rajatchaple/pcb_practice1/images/20220228_100533.jpg

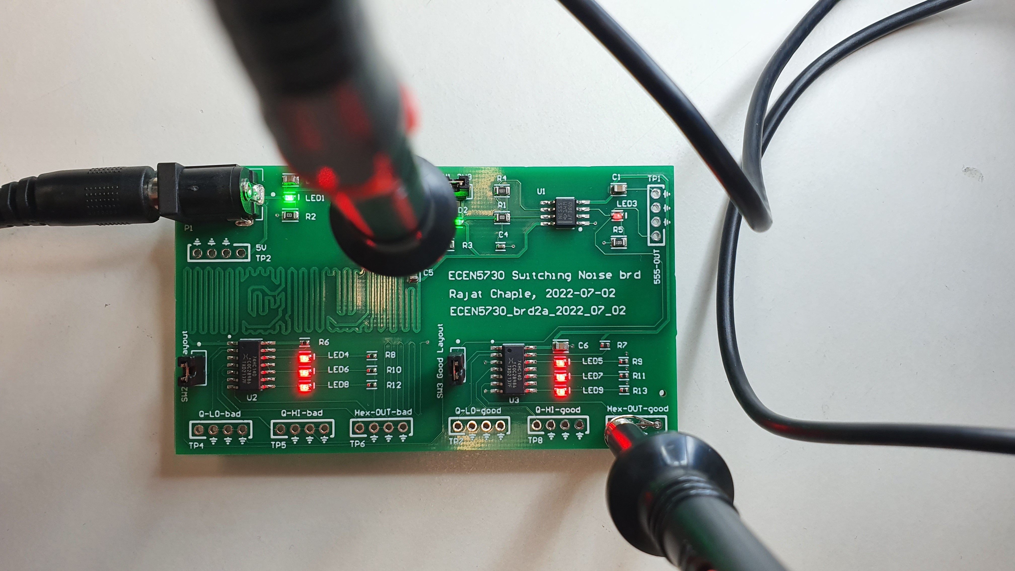
images/20220228_100533.jpg
