rajatchaple/pcb_practice1/images/20220228_100608.jpg

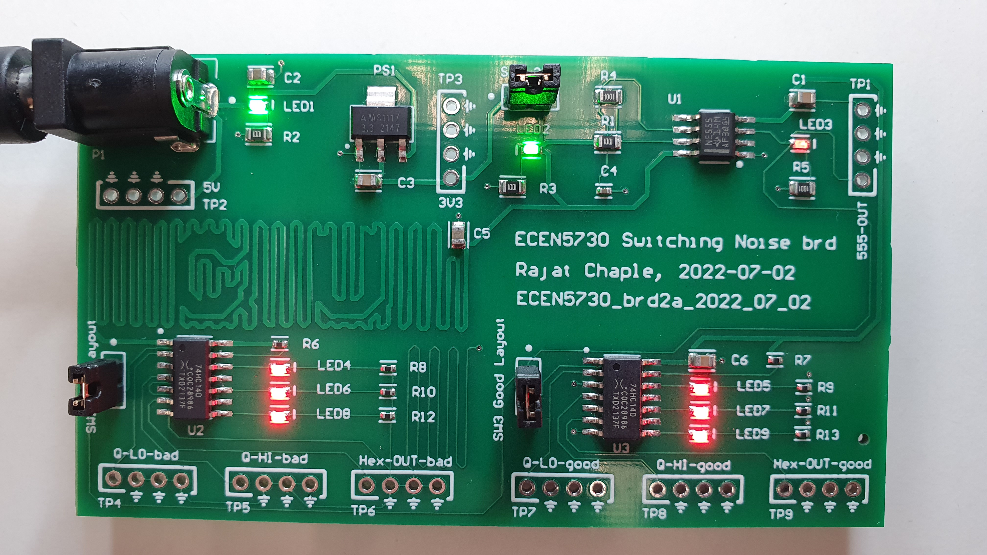
images/20220228_100608.jpg
