rajatchaple/pcb_practice1/images/20220228_100631.jpg

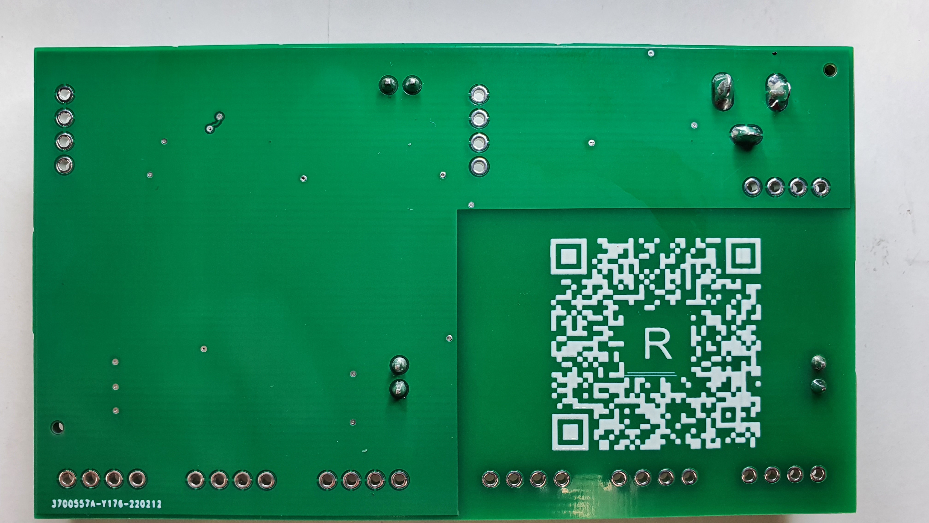
images/20220228_100631.jpg
