rajatchaple/pcb_practice1/images/board2_sch.png

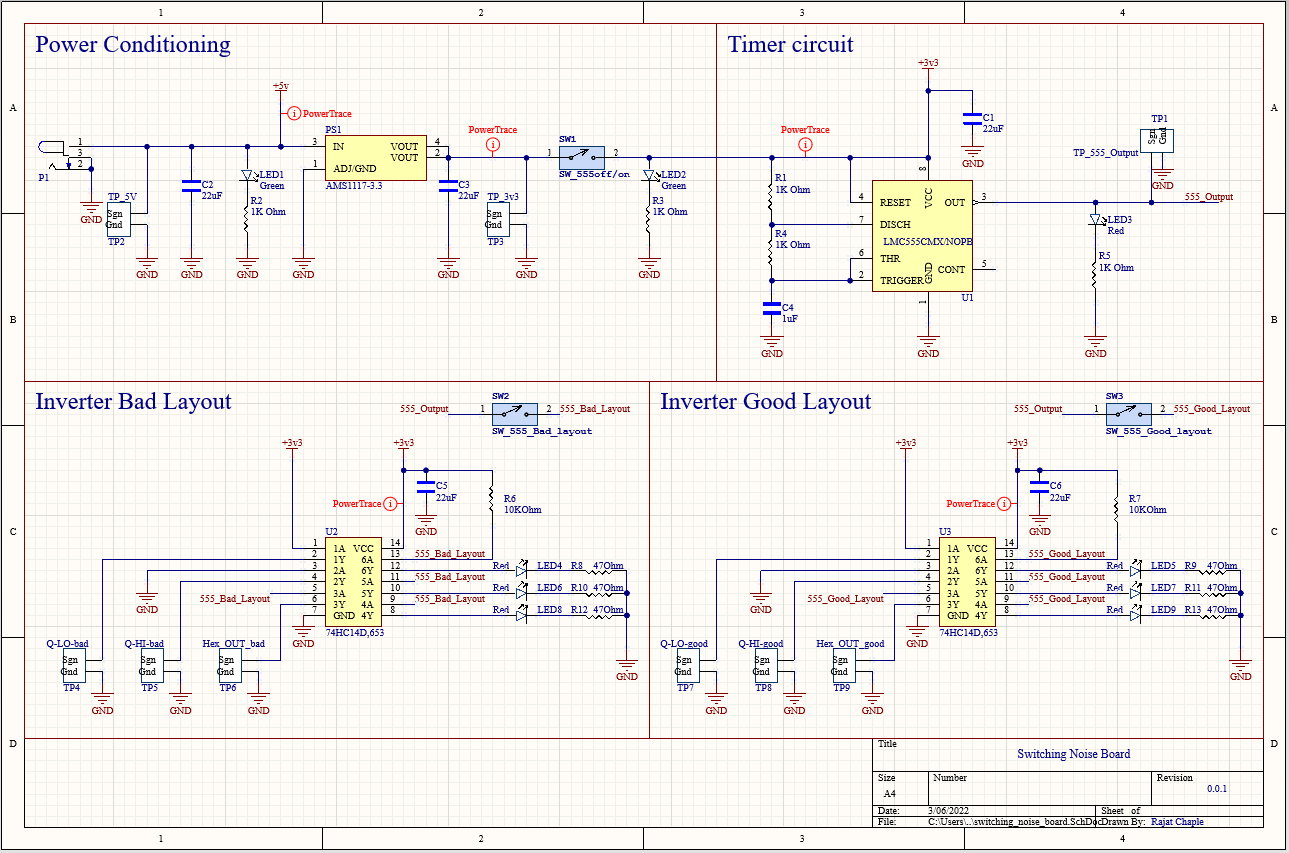
images/board2_sch.png
