rajatchaple/pcb_practice1/chaple_bom_switching_noise_brd_2022_02_09.xlsx

Comment | Description | Designator | Footprint | LibRef | Quantity | LCSC Part#
22uF | MULTILAYER CERAMIC CAPACITORS MLCC - SMD/SMT 22UF 25V 0805 ROHS | C1 | 0805_Passive_Capaciitor | C_22uF_0805 | 1 | C45783
22uF | MULTILAYER CERAMIC CAPACITORS MLCC - SMD/SMT 22UF 25V 0805 ROHS | C2 | 0805_Passive_Capaciitor | C_22uF_0805 | 1 | C45783
22uF | MULTILAYER CERAMIC CAPACITORS MLCC - SMD/SMT 22UF 25V 0805 ROHS | C3 | 0805_Passive_Capaciitor | C_22uF_0805 | 1 | C45783
1uF | MULTILAYER CERAMIC CAPACITORS MLCC - SMD/SMT 1UF 25V 0402 ROHS | C4 | 0402_Passive_Capacitor | C_1uF_0402 | 1 | C52923
22uF | MULTILAYER CERAMIC CAPACITORS MLCC - SMD/SMT 22UF 25V 0805 ROHS | C5 | 0805_Passive_Capaciitor | C_22uF_0805 | 1 | C45783
22uF | MULTILAYER CERAMIC CAPACITORS MLCC - SMD/SMT 22UF 25V 0805 ROHS | C6 | 0805_Passive_Capaciitor | C_22uF_0805 | 1 | C45783
KT-0603R | LIGHT EMITTING DIODES (LED) GREEN 520~535NM 112~258MCD@20MA TOP VIEW 0603 ROHS | LED1 | LED_0603 | LED_GREEN_0603 | 1 | C72043
KT-0603R | LIGHT EMITTING DIODES (LED) GREEN 520~535NM 112~258MCD@20MA TOP VIEW 0603 ROHS | LED2 | LED_0603 | LED_GREEN_0603 | 1 | C72043
KT-0603R | LIGHT EMITTING DIODES (LED) RED 520~625NM 90~100MCD@20MA TOP VIEW 0603 ROHS | LED3 | LED_0603 | LED_RED_0603 | 1 | C2286
KT-0603R | LIGHT EMITTING DIODES (LED) RED 520~625NM 90~100MCD@20MA TOP VIEW 0603 ROHS | LED4 | LED_0603 | LED_RED_0603 | 1 | C2286
KT-0603R | LIGHT EMITTING DIODES (LED) RED 520~625NM 90~100MCD@20MA TOP VIEW 0603 ROHS | LED5 | LED_0603 | LED_RED_0603 | 1 | C2286
KT-0603R | LIGHT EMITTING DIODES (LED) RED 520~625NM 90~100MCD@20MA TOP VIEW 0603 ROHS | LED6 | LED_0603 | LED_RED_0603 | 1 | C2286
KT-0603R | LIGHT EMITTING DIODES (LED) RED 520~625NM 90~100MCD@20MA TOP VIEW 0603 ROHS | LED7 | LED_0603 | LED_RED_0603 | 1 | C2286
KT-0603R | LIGHT EMITTING DIODES (LED) RED 520~625NM 90~100MCD@20MA TOP VIEW 0603 ROHS | LED8 | LED_0603 | LED_RED_0603 | 1 | C2286
KT-0603R | LIGHT EMITTING DIODES (LED) RED 520~625NM 90~100MCD@20MA TOP VIEW 0603 ROHS | LED9 | LED_0603 | LED_RED_0603 | 1 | C2286
Power Jack | Power Barrel Connector Jack 2.10mm ID (0.083"), 5.50mm OD (0.217") Through Hole, Right Angle | P1 | Power_Jack | P_Power Jack | 1 | C136744
AMS1117-3.3 | LOW DROPOUT REGULATORS(LDO) POSITIVE FIXED 1.3V @ 800MA 15V 3.3V 1A SOT-223 ROHS | PS1 | LDO | PS_AMS_LDO_3v3 | 1 | C6186
1k | CHIP RESISTOR - SURFACE MOUNT 1KOHMS ±1% 1/8W 0805 ROHS | R1 | 0805_Passive_Resistor | R_1K_0805 | 1 | C17513
1k | CHIP RESISTOR - SURFACE MOUNT 1KOHMS ±1% 1/8W 0805 ROHS | R2 | 0805_Passive_Resistor | R_1K_0805 | 1 | C17513
1k | CHIP RESISTOR - SURFACE MOUNT 1KOHMS ±1% 1/8W 0805 ROHS | R3 | 0805_Passive_Resistor | R_1K_0805 | 1 | C17513
1k | CHIP RESISTOR - SURFACE MOUNT 1KOHMS ±1% 1/8W 0805 ROHS | R4 | 0805_Passive_Resistor | R_1K_0805 | 1 | C17513
1k | CHIP RESISTOR - SURFACE MOUNT 1KOHMS ±1% 1/8W 0805 ROHS | R5 | 0805_Passive_Resistor | R_1K_0805 | 1 | C17513
10k | CHIP RESISTOR - SURFACE MOUNT 10KOHMS ±1% 1/16W 0402 ROHS | R6 | 0402_Passive_Resistor | R_10KOhm_0402 | 1 | C25744
10k | CHIP RESISTOR - SURFACE MOUNT 10KOHMS ±1% 1/16W 0402 ROHS | R7 | 0402_Passive_Resistor | R_10KOhm_0402 | 1 | C25744
47 Ohms | CHIP RESISTOR - SURFACE MOUNT 47OHMS ±1% 1/16W 0402 ROHS | R8 | 0402_Passive_Resistor | R_47Ohm_0402 | 1 | C25118
47 Ohms | CHIP RESISTOR - SURFACE MOUNT 47OHMS ±1% 1/16W 0402 ROHS | R9 | 0402_Passive_Resistor | R_47Ohm_0402 | 1 | C25118
47 Ohms | CHIP RESISTOR - SURFACE MOUNT 47OHMS ±1% 1/16W 0402 ROHS | R10 | 0402_Passive_Resistor | R_47Ohm_0402 | 1 | C25118
47 Ohms | CHIP RESISTOR - SURFACE MOUNT 47OHMS ±1% 1/16W 0402 ROHS | R11 | 0402_Passive_Resistor | R_47Ohm_0402 | 1 | C25118
47 Ohms | CHIP RESISTOR - SURFACE MOUNT 47OHMS ±1% 1/16W 0402 ROHS | R12 | 0402_Passive_Resistor | R_47Ohm_0402 | 1 | C25118
47 Ohms | CHIP RESISTOR - SURFACE MOUNT 47OHMS ±1% 1/16W 0402 ROHS | R13 | 0402_Passive_Resistor | R_47Ohm_0402 | 1 | C25118
SW_555off/on | 2Pin Header | SW1 | 2Pin-Header-Conn | SW_2Pin_100mil_Switch | 1 | C124375
SW_555_Bad_layout | 2Pin Header | SW2 | 2Pin-Header-Conn | SW_2Pin_100mil_Switch | 1 | C124375
SW_555_Good_layout | 2Pin Header | SW3 | 2Pin-Header-Conn | SW_2Pin_100mil_Switch | 1 | C124375
TP_555_Output | Test Point 300 mil centers | TP1 | TP10x_Probe | TP_10x_Probe | 1
TP_5V | Test Point 300 mil centers | TP2 | TP10x_Probe | TP_10x_Probe | 1
TP_3v3 | Test Point 300 mil centers | TP3 | TP10x_Probe | TP_10x_Probe | 1
Q-LO-bad | Test Point 300 mil centers | TP4 | TP10x_Probe | TP_10x_Probe | 1
Q-HI-bad | Test Point 300 mil centers | TP5 | TP10x_Probe | TP_10x_Probe | 1
Hex_OUT_bad | Test Point 300 mil centers | TP6 | TP10x_Probe | TP_10x_Probe | 1
Q-LO-good | Test Point 300 mil centers | TP7 | TP10x_Probe | TP_10x_Probe | 1
Q-HI-good | Test Point 300 mil centers | TP8 | TP10x_Probe | TP_10x_Probe | 1
Hex_OUT_good | Test Point 300 mil centers | TP9 | TP10x_Probe | TP_10x_Probe | 1
LMC555CMX/NOPB | 555 Type, Timer/Oscillator _Single_ IC 3MHz 8-SO | U1 | TS555IDTTR | U_555_Fast | 1 | C90760
74HC14D,653 | Inverter IC 6 Channel Schmitt Trigger 14-SOIC | U2 | HEX_74AC14 | U_7414_HC_Hex | 1 | C5605
74HC14D,653 | Inverter IC 6 Channel Schmitt Trigger 14-SOIC | U3 | HEX_74AC14 | U_7414_HC_Hex | 1 | C5605
