rajatchaple/pcb_practice1/(list of files, drawings)

Other design files:
switching_noise_board.PcbDoc
switching_noise_board.PrjPcb
switching_noise_board.SchDoc
