rajatchaple/pcb_practice1/(commit log)

2022-01-19 schematic & layout v0.1.0
    [ECEN5730_brd1a_2022-15-01.DRL, ECEN5730_brd1a_2022-15-01.GBL, ECEN5730_brd1a_2022-15-01.GBS, ECEN5730_brd1a_2022-15-01.GKO, ECEN5730_brd1a_2022-15-01.GTL, ECEN5730_brd1a_2022-15-01.GTO, ECEN5730_brd1a_2022-15-01.GTP, ECEN5730_brd1a_2022-15-01.GTS]
2023-02-27 added .gitignore
    [ECEN5730_brd1a_2022-15-01.DRL, ECEN5730_brd1a_2022-15-01.GBL, ECEN5730_brd1a_2022-15-01.GBS, ECEN5730_brd1a_2022-15-01.GKO, ECEN5730_brd1a_2022-15-01.GTL, ECEN5730_brd1a_2022-15-01.GTO, ECEN5730_brd1a_2022-15-01.GTP, ECEN5730_brd1a_2022-15-01.GTS]
